miehcle/P17EC003/資料/f401re.png

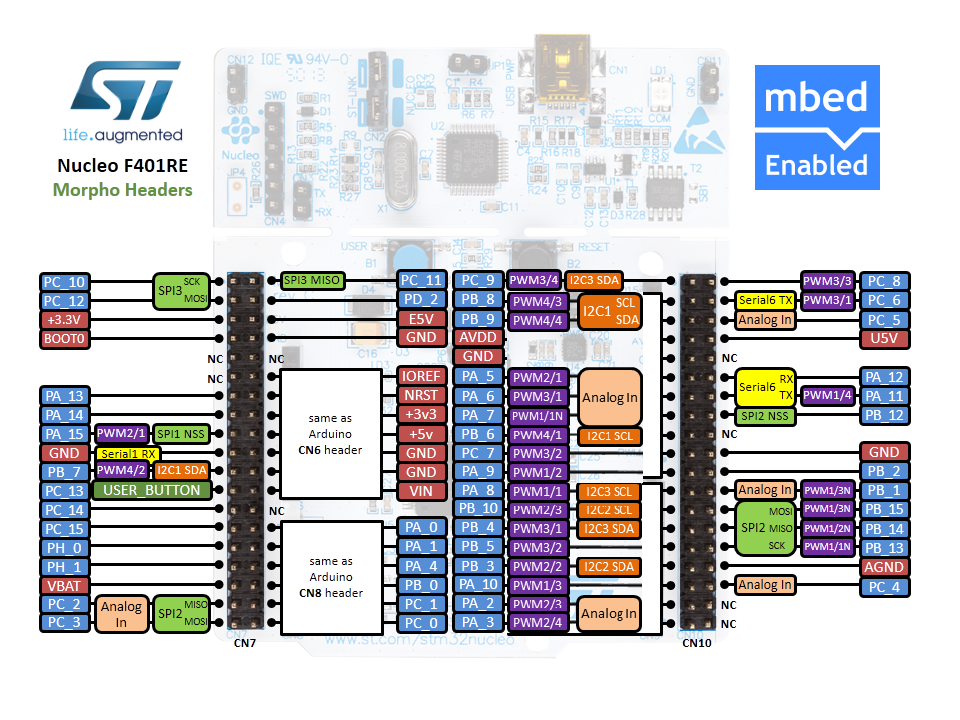
資料/f401re.png
