miehcle/P17EC003/README.md

# P17EC003_Motor_Driver
Ene-1GP 2017 モータードライバ（旧車体用）
