miehcle/P17EC003/仕様書/P17EC003_仕様書.docx

2017年　　2月　　11日

三重大学電気自動車研究会

Ene-1GP2017旧車体用モータードライバ

設計仕様書

作成者：　伊坂　脩

1. 概要
2. 目的
3. 目標
4. コンセプト
5. 目次
6. 仕様
  6.1. 構成部品
  6.2. スペック
7. ハードウェア
  7.1. ハードウェア構成図
  7.2. ハードウェア機能概要
  7.3. ハードウェア機能詳細
8. ソフトウェア
  8.1. ソフトウェア
  8.2. ソフトウェア構成図
  8.3. ソフトウェア機能詳細
9. 試験
10. 開発体制
11. 予算
