miehcle/P17EC003/報告書/ene1gp_houkoku_1.pdf

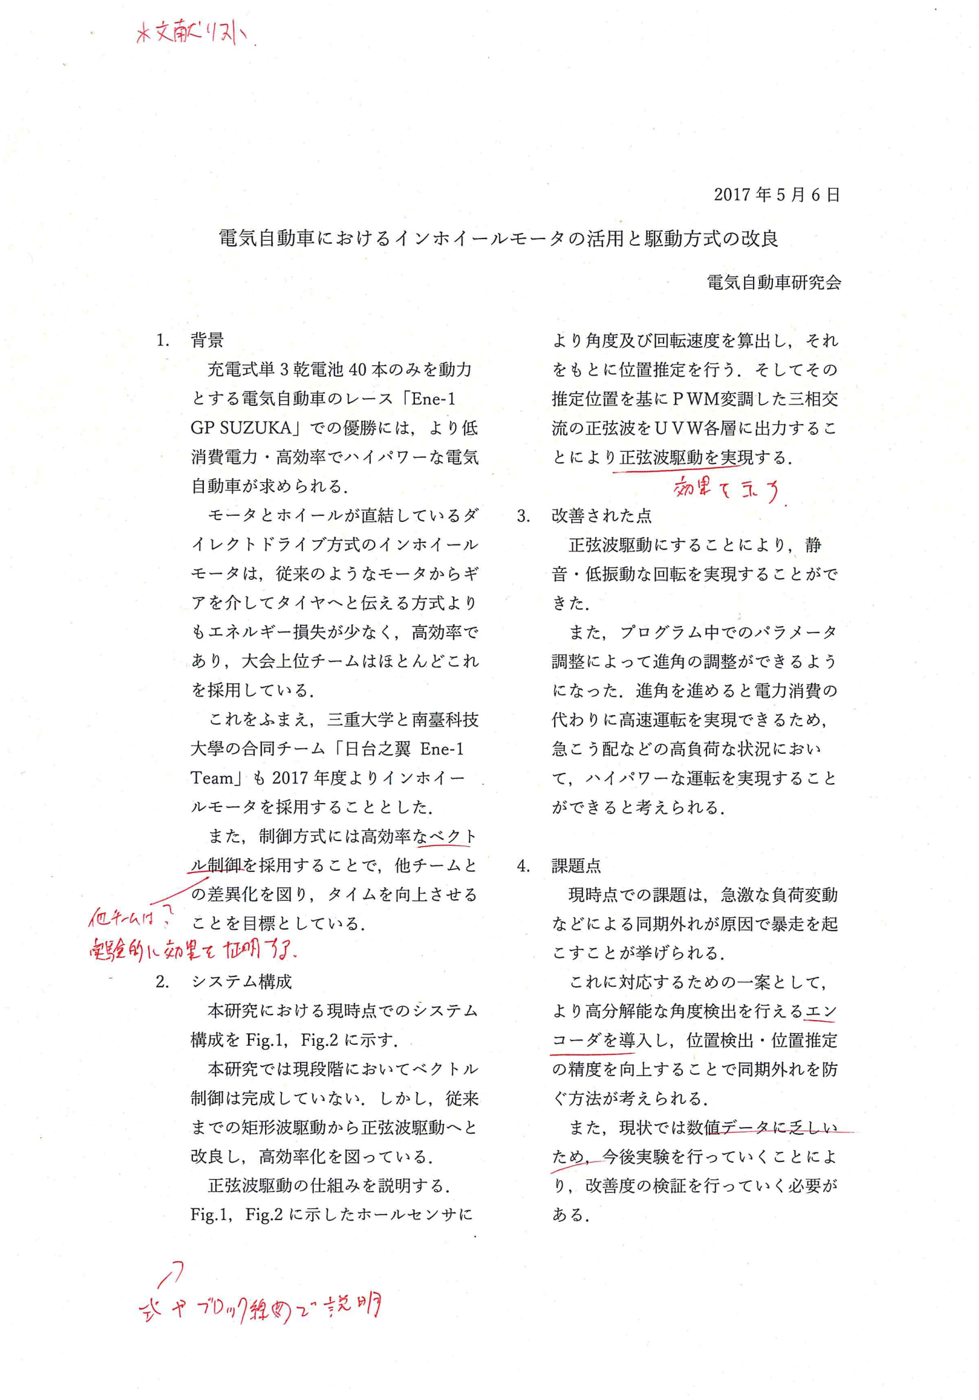
[picture p2: page 1]
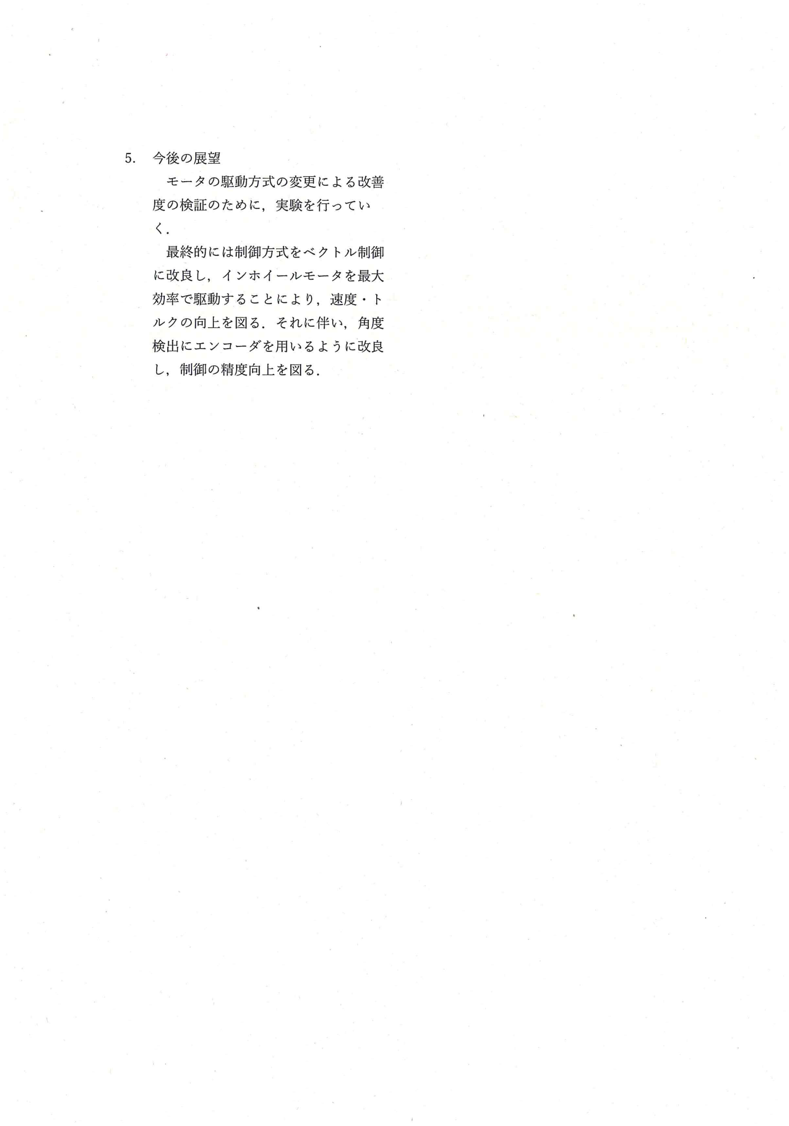
[picture p3: page 2]
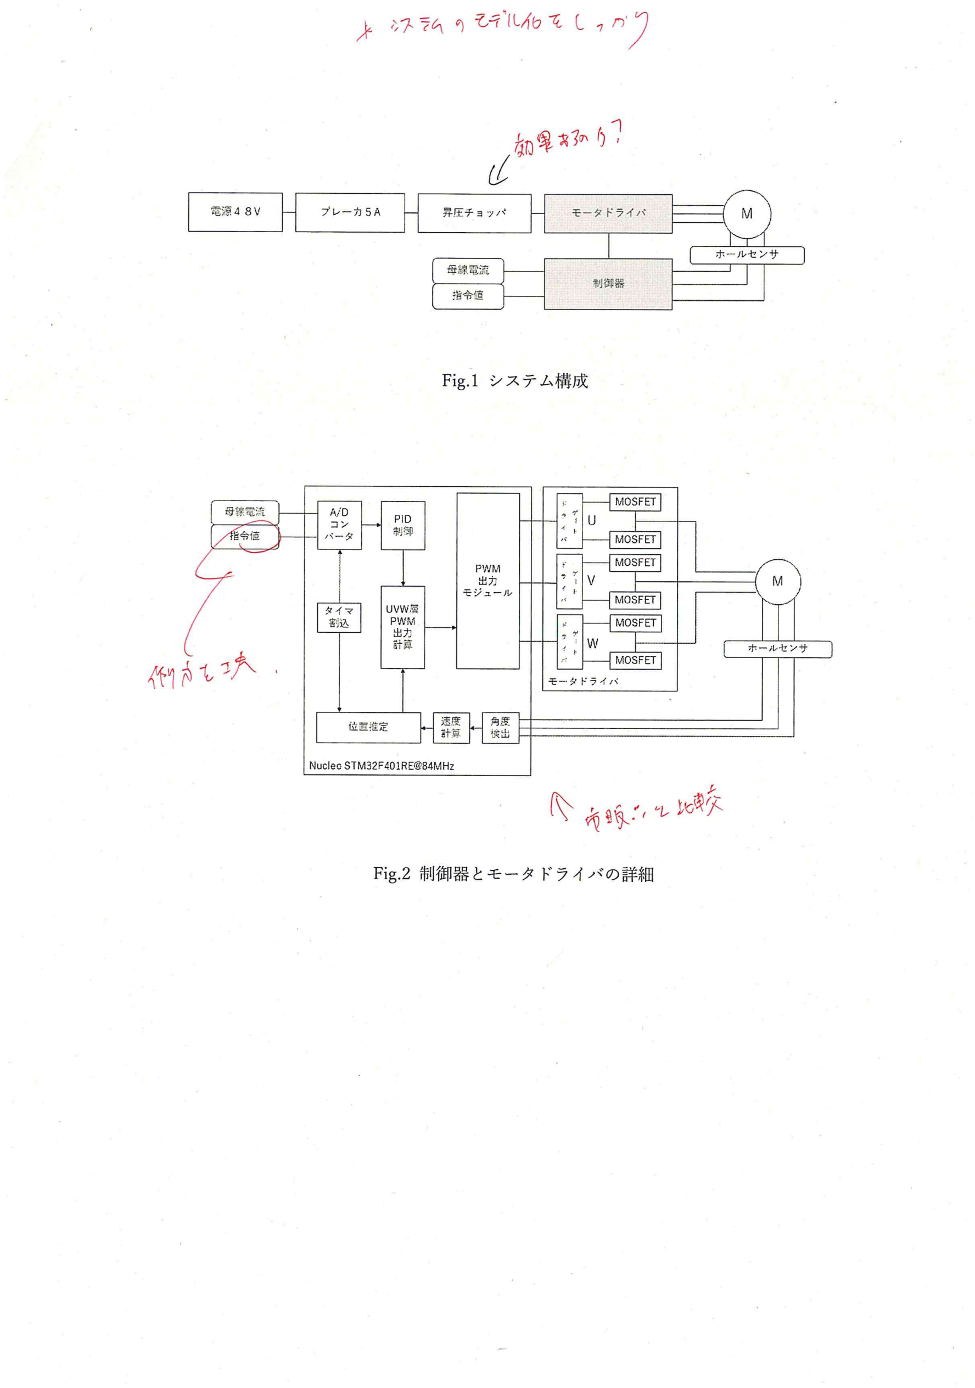
[picture p4: page 3]
