miehcle/P17EC003/設計/sine_driver_offline_ver3/Bサイズ基板.png

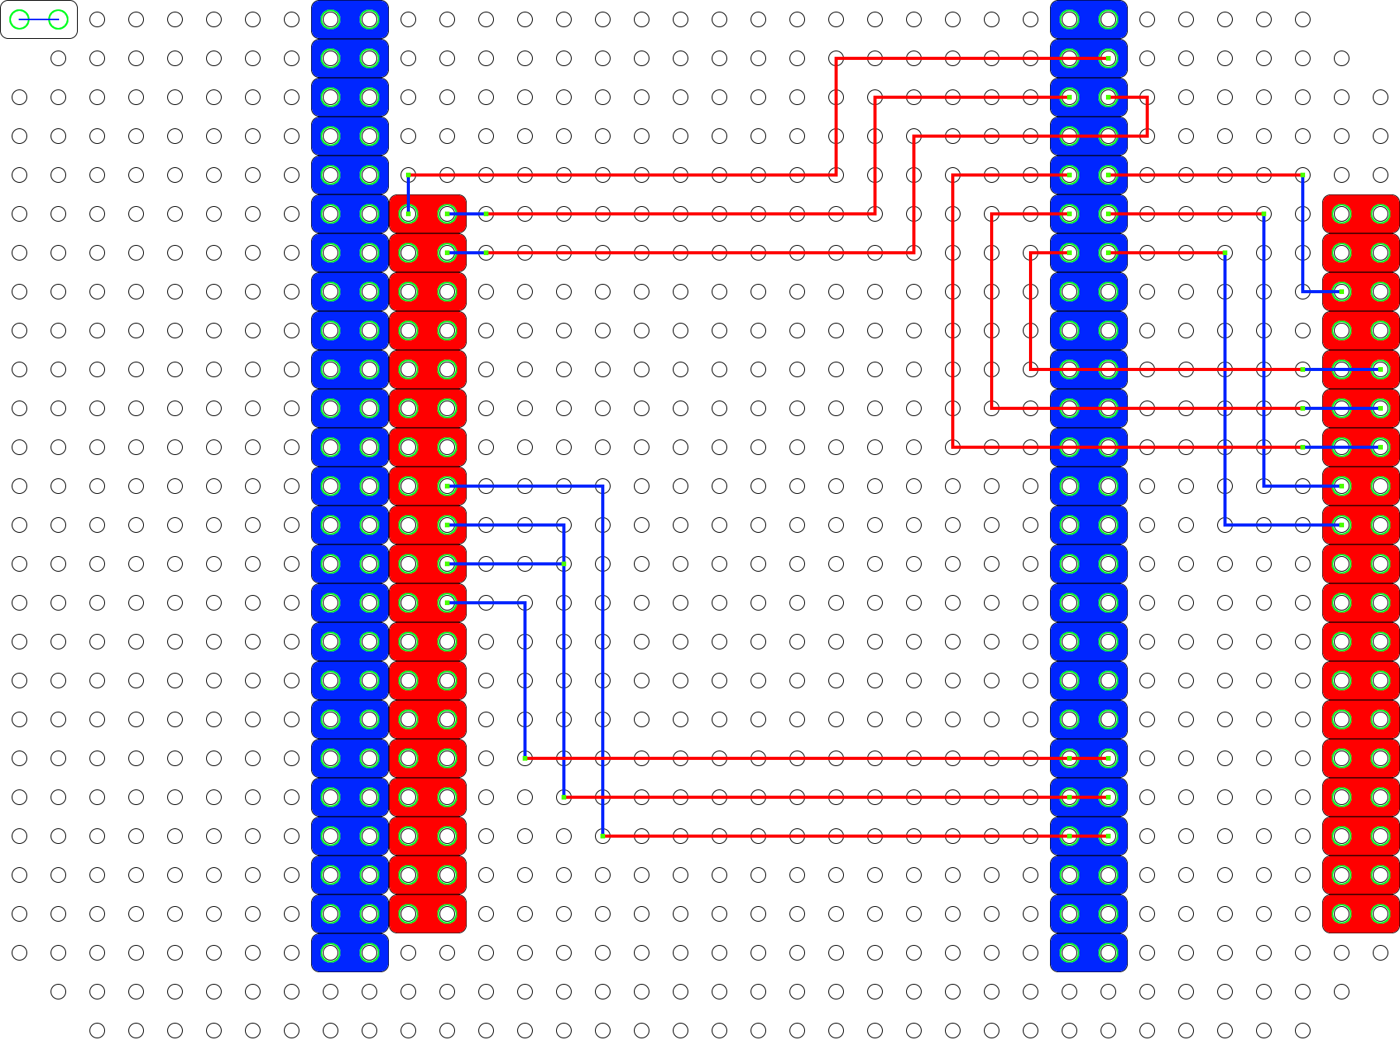
設計/sine_driver_offline_ver3/Bサイズ基板.png
