miehcle/P17EC003/設計/sine_driver_offline_ver3/driver_pinmap.png

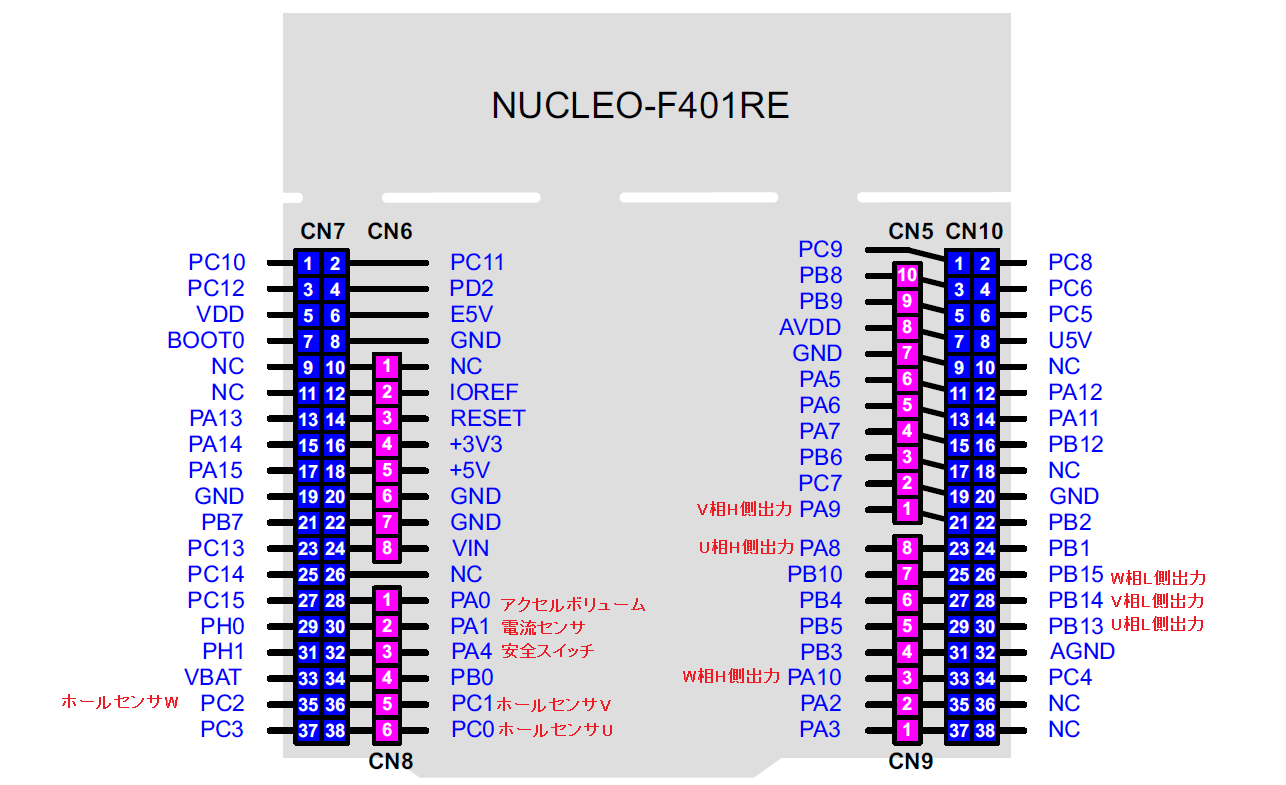
設計/sine_driver_offline_ver3/driver_pinmap.png
