miehcle/P17EC003/設計/sine_driver_offline_ver3/mbedriver_adaptor_board_revised.png

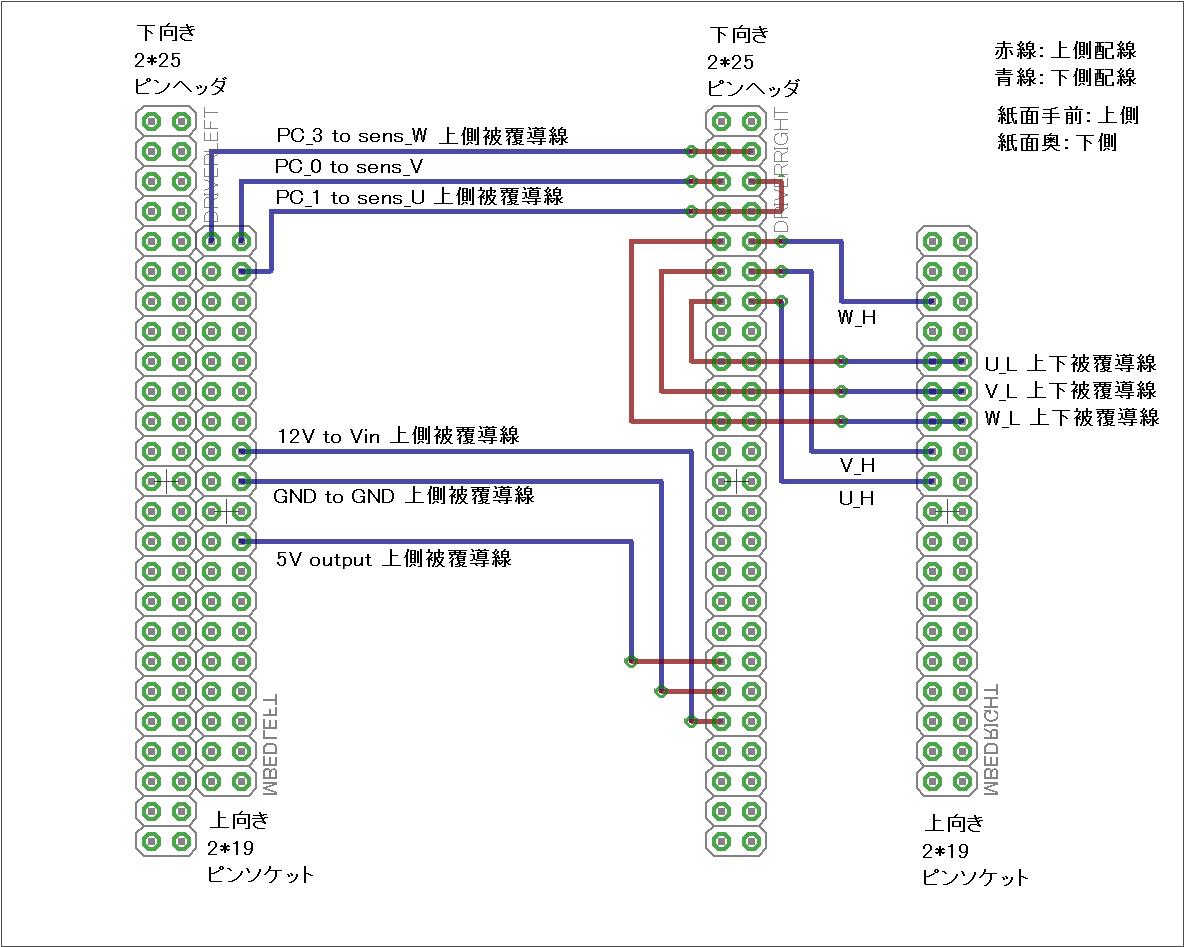
設計/sine_driver_offline_ver3/mbedriver_adaptor_board_revised.png
