miehcle/P17EC003/試験/PWMsineWave/pwm_tri_sinewave_circuit.jpg

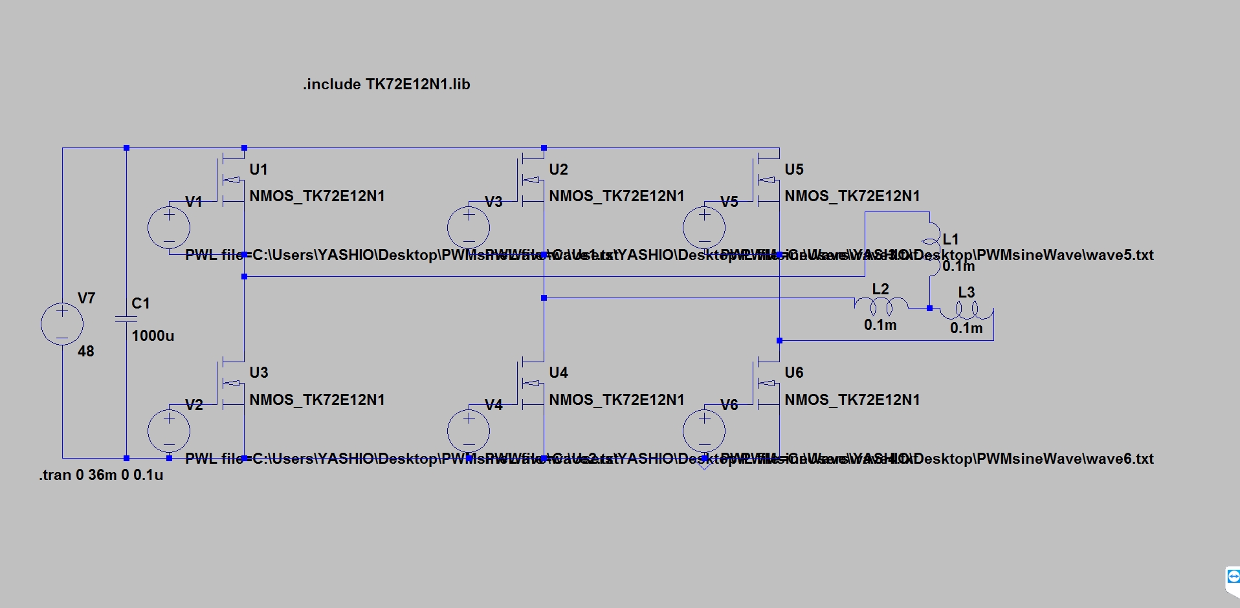
試験/PWMsineWave/pwm_tri_sinewave_circuit.jpg
