miehcle/P17EC003/試験/PWMsineWave/pwm_tri_sinewave_simulate.jpg

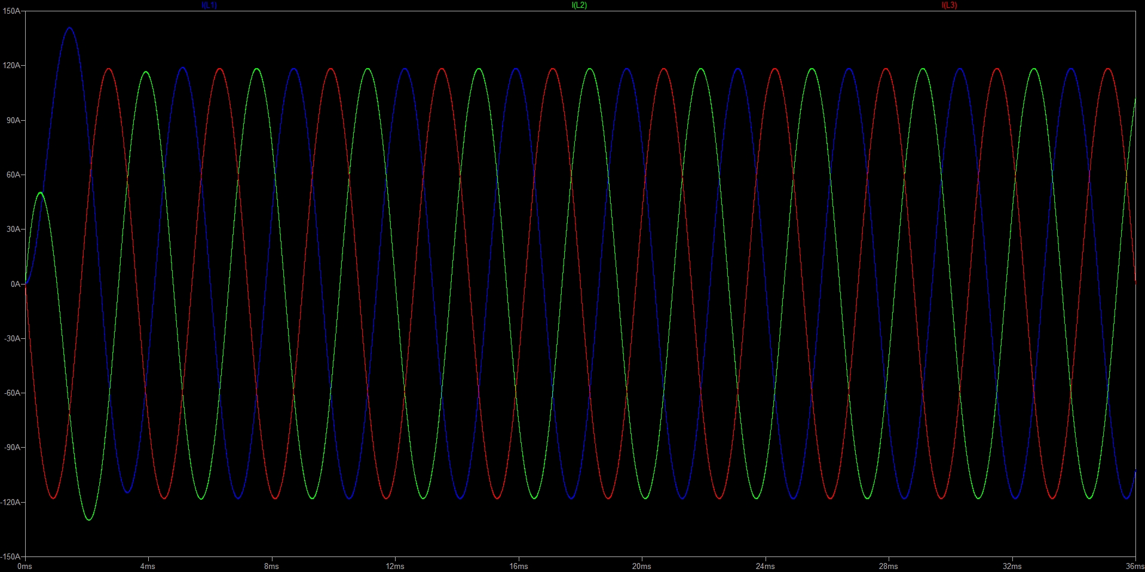
試験/PWMsineWave/pwm_tri_sinewave_simulate.jpg
