miehcle/P17EC003/予算/部品単価表.docx

各部位 | 使用パーツ | 単価格
制御用マイコン | ARM401RE | \1800
モータードライバ | 三菱DIPIPM PSS20S92F6 | \5000
マイコン用DCDCコン | COSEL SUS3 4805C,4815C | 各\1100
角度センサ | 旭化成エンコーダ | ？
電流センサ | ACS712 | \1400
ゲートドライバ | Infinion 942-IRS2186PBF | \450
