miehcle/P17EC003/(list of files, cad)

Other CAD files:
設計/kari/rear_cad.skp
設計/kari/rear_cad_15mm.skp
