miehcle/P17EC003/資料/F401RE_printfの受信方法/readme.txt

F01REのUSB接続をバーチャルCOMとして使う

1. OSのオペレーションビットにあわせて"en.stsw-link009"フォルダ内の"dpinst_x86.exe"または"dpinst_amd64.exe"を実行

2.流れに従ってそのままインストール

受信用のターミナルソフトを入れる

1.teraterm-4.94.exeを実行

2.コンポーネントの選択で「コンパクトインストール」を選択

3.流れに従ってインストール

4.TeraTermを起動

5.新しい接続でシリアルを選択、マイコンが接続されているCOMポートを選択

6.「設定」→「端末」を選択

7.改行コードを「受信：LF」に変更して「OK」

あとはマイコンよりprintfを受信できます。
