miehcle/P17EC003/試験/PWMsineWave/pwmtriwave.asc

C1: cap; 1000u
L1: ind; 0.1m; Rser=0.1
L2: ind; 0.1m; Rser=0.1
L3: ind; 0.1m; Rser=0.1
U1: TK72E12N1
U2: TK72E12N1
U3: TK72E12N1
U4: TK72E12N1
U5: TK72E12N1
U6: TK72E12N1
V1: voltage; PWL file=C:\Users\YASHIO\Desktop\PWMsineWave\wave1.txt
V2: voltage; PWL file=C:\Users\YASHIO\Desktop\PWMsineWave\wave2.txt
V3: voltage; PWL file=C:\Users\YASHIO\Desktop\PWMsineWave\wave3.txt
V4: voltage; PWL file=C:\Users\YASHIO\Desktop\PWMsineWave\wave4.txt
V5: voltage; PWL file=C:\Users\YASHIO\Desktop\PWMsineWave\wave5.txt
V6: voltage; PWL file=C:\Users\YASHIO\Desktop\PWMsineWave\wave6.txt
V7: voltage; 48
Named nets: 0
.include TK72E12N1.lib
.tran 0 36m 0 0.1u
