miehcle/P17EC003/設計/sine_driver_offline_ver3/sine_driver_offline_ver3.ioc

Mcu.UserName=STM32F401RETx
PA0-WKUP.GPIO_Label=accel
PA0-WKUP.Signal=ADCx_IN0
PA1.GPIO_Label=current
PA1.Signal=ADCx_IN1
PA10.Signal=S_TIM1_CH3
PA13.GPIO_Label=TMS
PA13.Signal=SYS_JTMS-SWDIO
PA14.GPIO_Label=TCK
PA14.Signal=SYS_JTCK-SWCLK
PA2.GPIO_Label=USART_TX
PA2.Signal=USART2_TX
PA3.GPIO_Label=USART_RX
PA3.Signal=USART2_RX
PA4.GPIO_Label=safetyswitch
PA4.Signal=GPIO_Input
PA5.GPIO_Label=LD2 [Green Led]
PA5.Signal=GPIO_Output
PA8.Signal=S_TIM1_CH1
PA9.Signal=S_TIM1_CH2
PB13.Signal=TIM1_CH1N
PB14.Signal=TIM1_CH2N
PB15.Signal=TIM1_CH3N
PB3.Signal=SYS_JTDO-SWO
PC0.GPIO_Label=sensU
PC0.Signal=GPXTI0
PC1.GPIO_Label=sensV
PC1.Signal=GPXTI1
PC13-ANTI_TAMP.GPIO_Label=B1 [Blue PushButton]
PC13-ANTI_TAMP.Signal=GPXTI13
PC14-OSC32_IN.Signal=RCC_OSC32_IN
PC15-OSC32_OUT.Signal=RCC_OSC32_OUT
PC2.GPIO_Label=sensW
PC2.Signal=GPXTI2
