miehcle/P17EC003/(notices)

Notices in the files:
設計/sine_driver_offline_ver3/Src/main.c:
(C) COPYRIGHT STMicroelectronics *****END OF FILE
